prusa3d/MK3_Power_Panic/README.md

# MK3 Power Panic
KiCad PCB layout
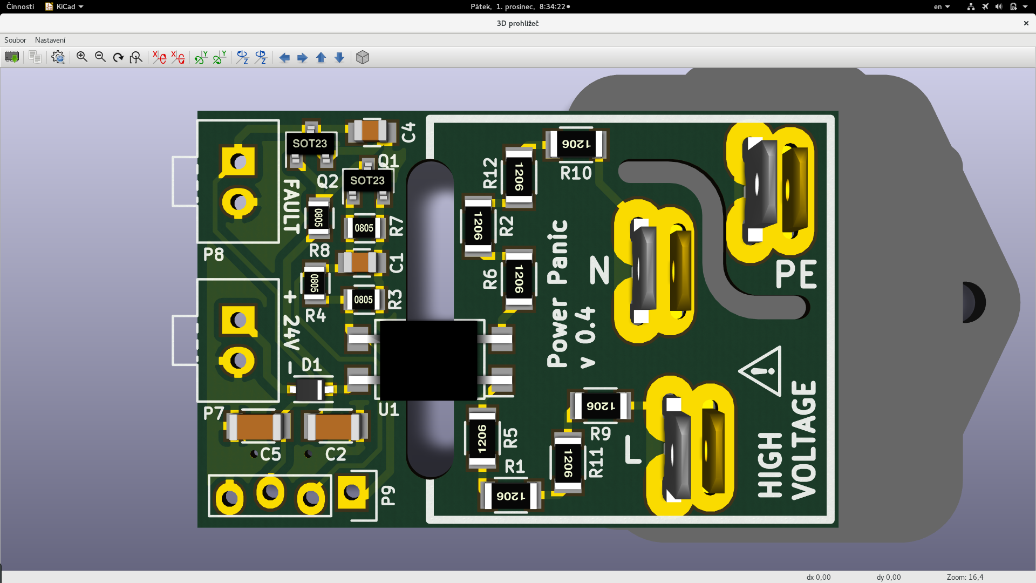
[picture p1: rev.04/power-panic.png]
PCB
