prusa3d/MK3_Power_Panic/rev.04/power-panic.pdf

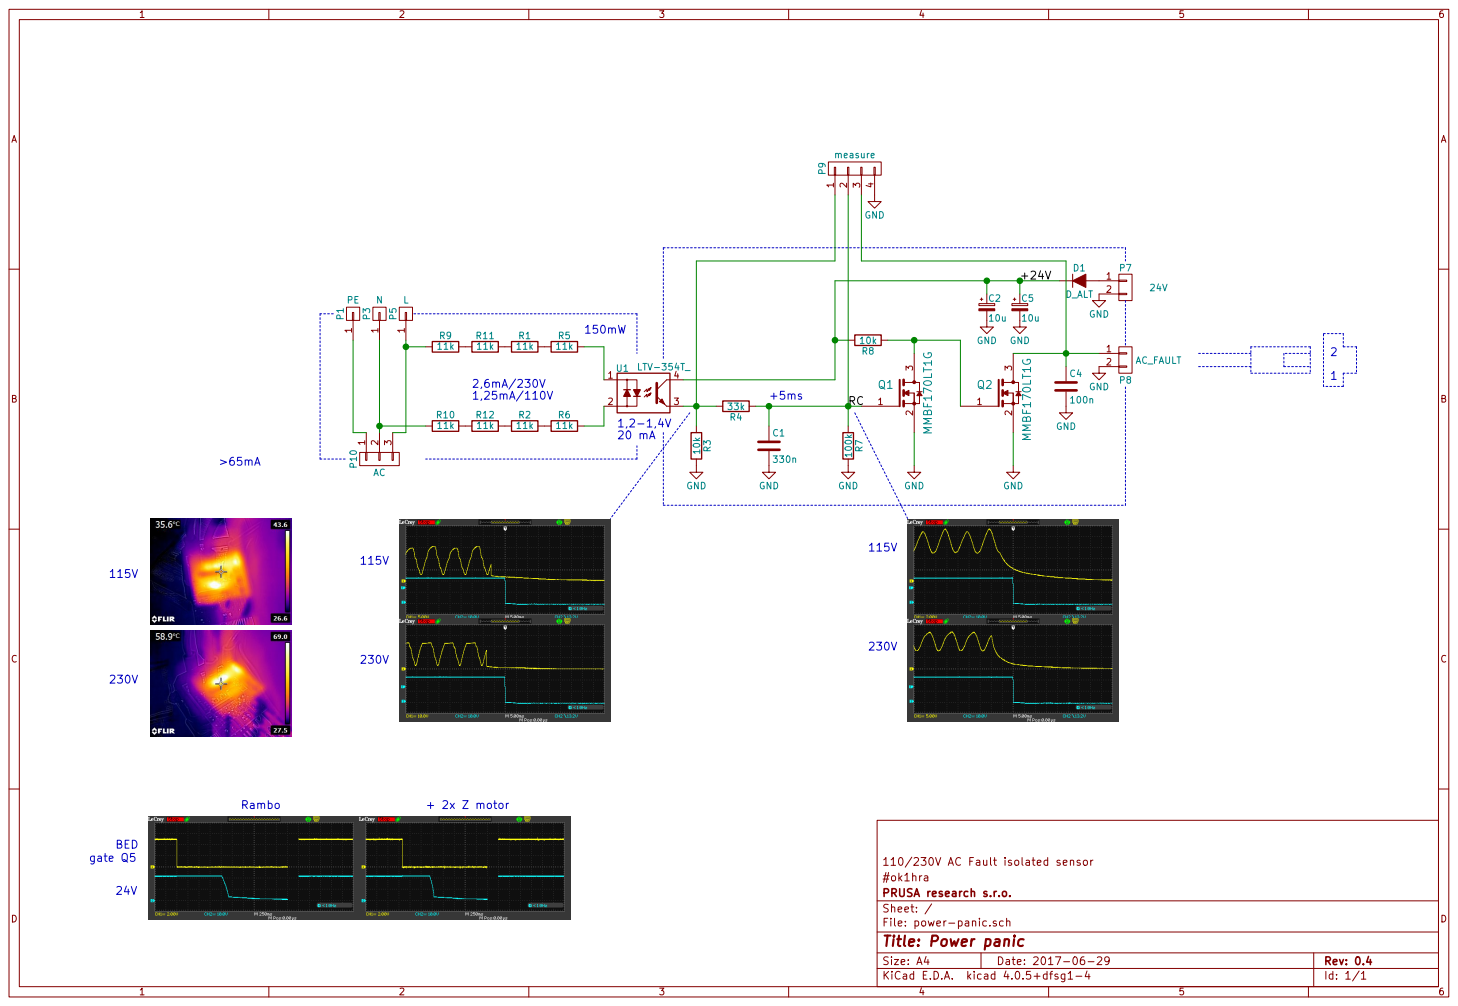
[picture p2: page 1]

https://www.allaboutcircuits.com/tools/capacitor-Charge-and-time-constant-calculator/ 1

110/230V AC Fault isolated sensor
File: power-panic.sch Sheet: / PRUSA research s.r.o. #ok1hra

Id: 1/1 Title: Power panic
