prusa3d/MK3_Power_Panic/rev._Delta_PMZ-24V240WDAL/Delta_PMZ-24V240WDAL.pdf

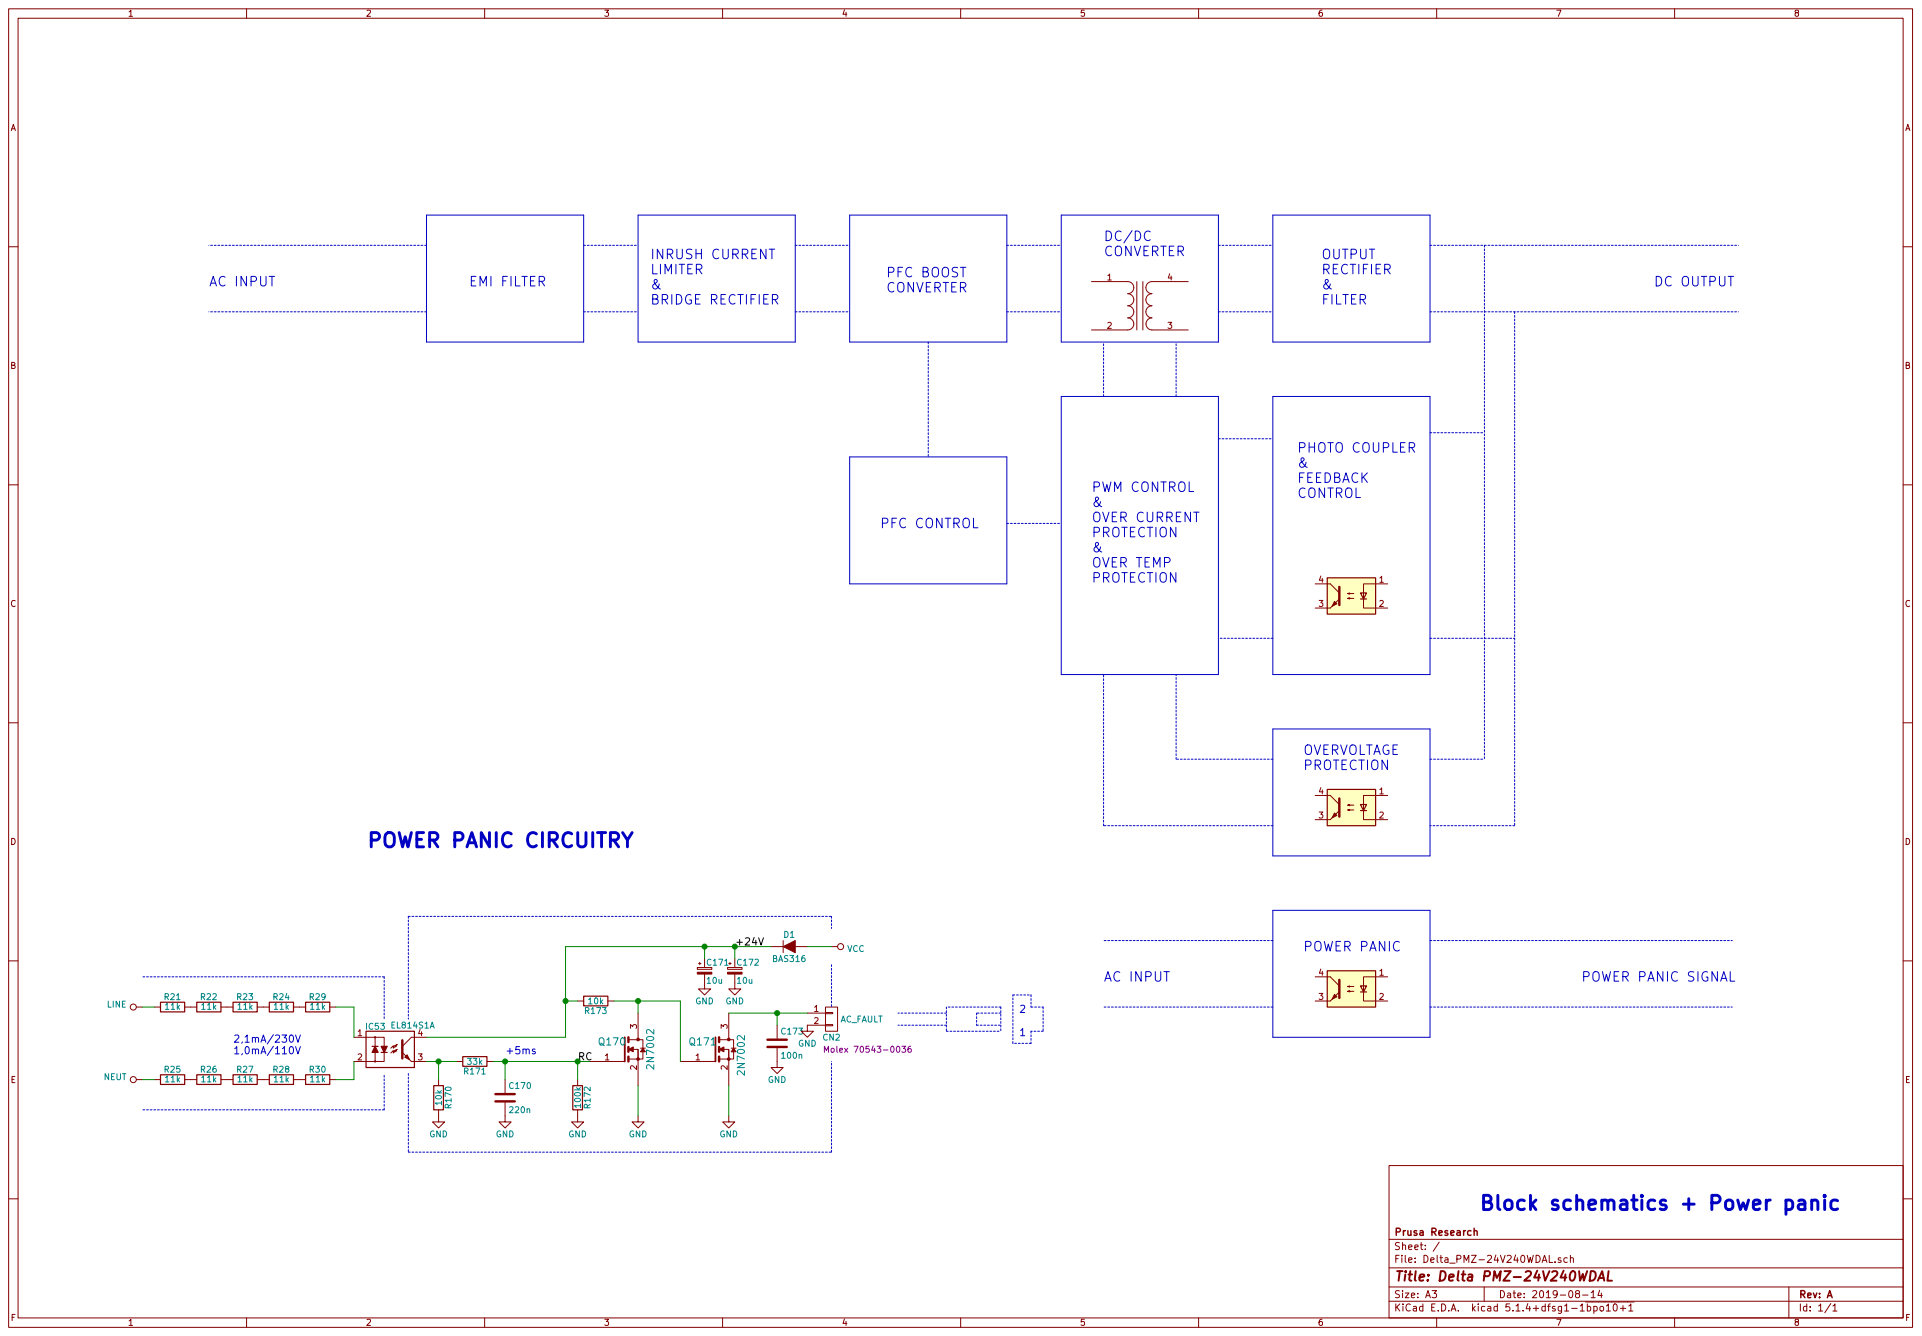
[picture p3: page 1]

File: Delta_PMZ-24V240WDAL.sch Sheet: / Prusa Research C172

Id: 1/1 Title: Delta PMZ-24V240WDAL
