prusa3d/MK3_Power_Panic/rev.04/power-panic.kicad_pcb

## KiCad design rev.04/power-panic.kicad_pcb (2017-12-01)

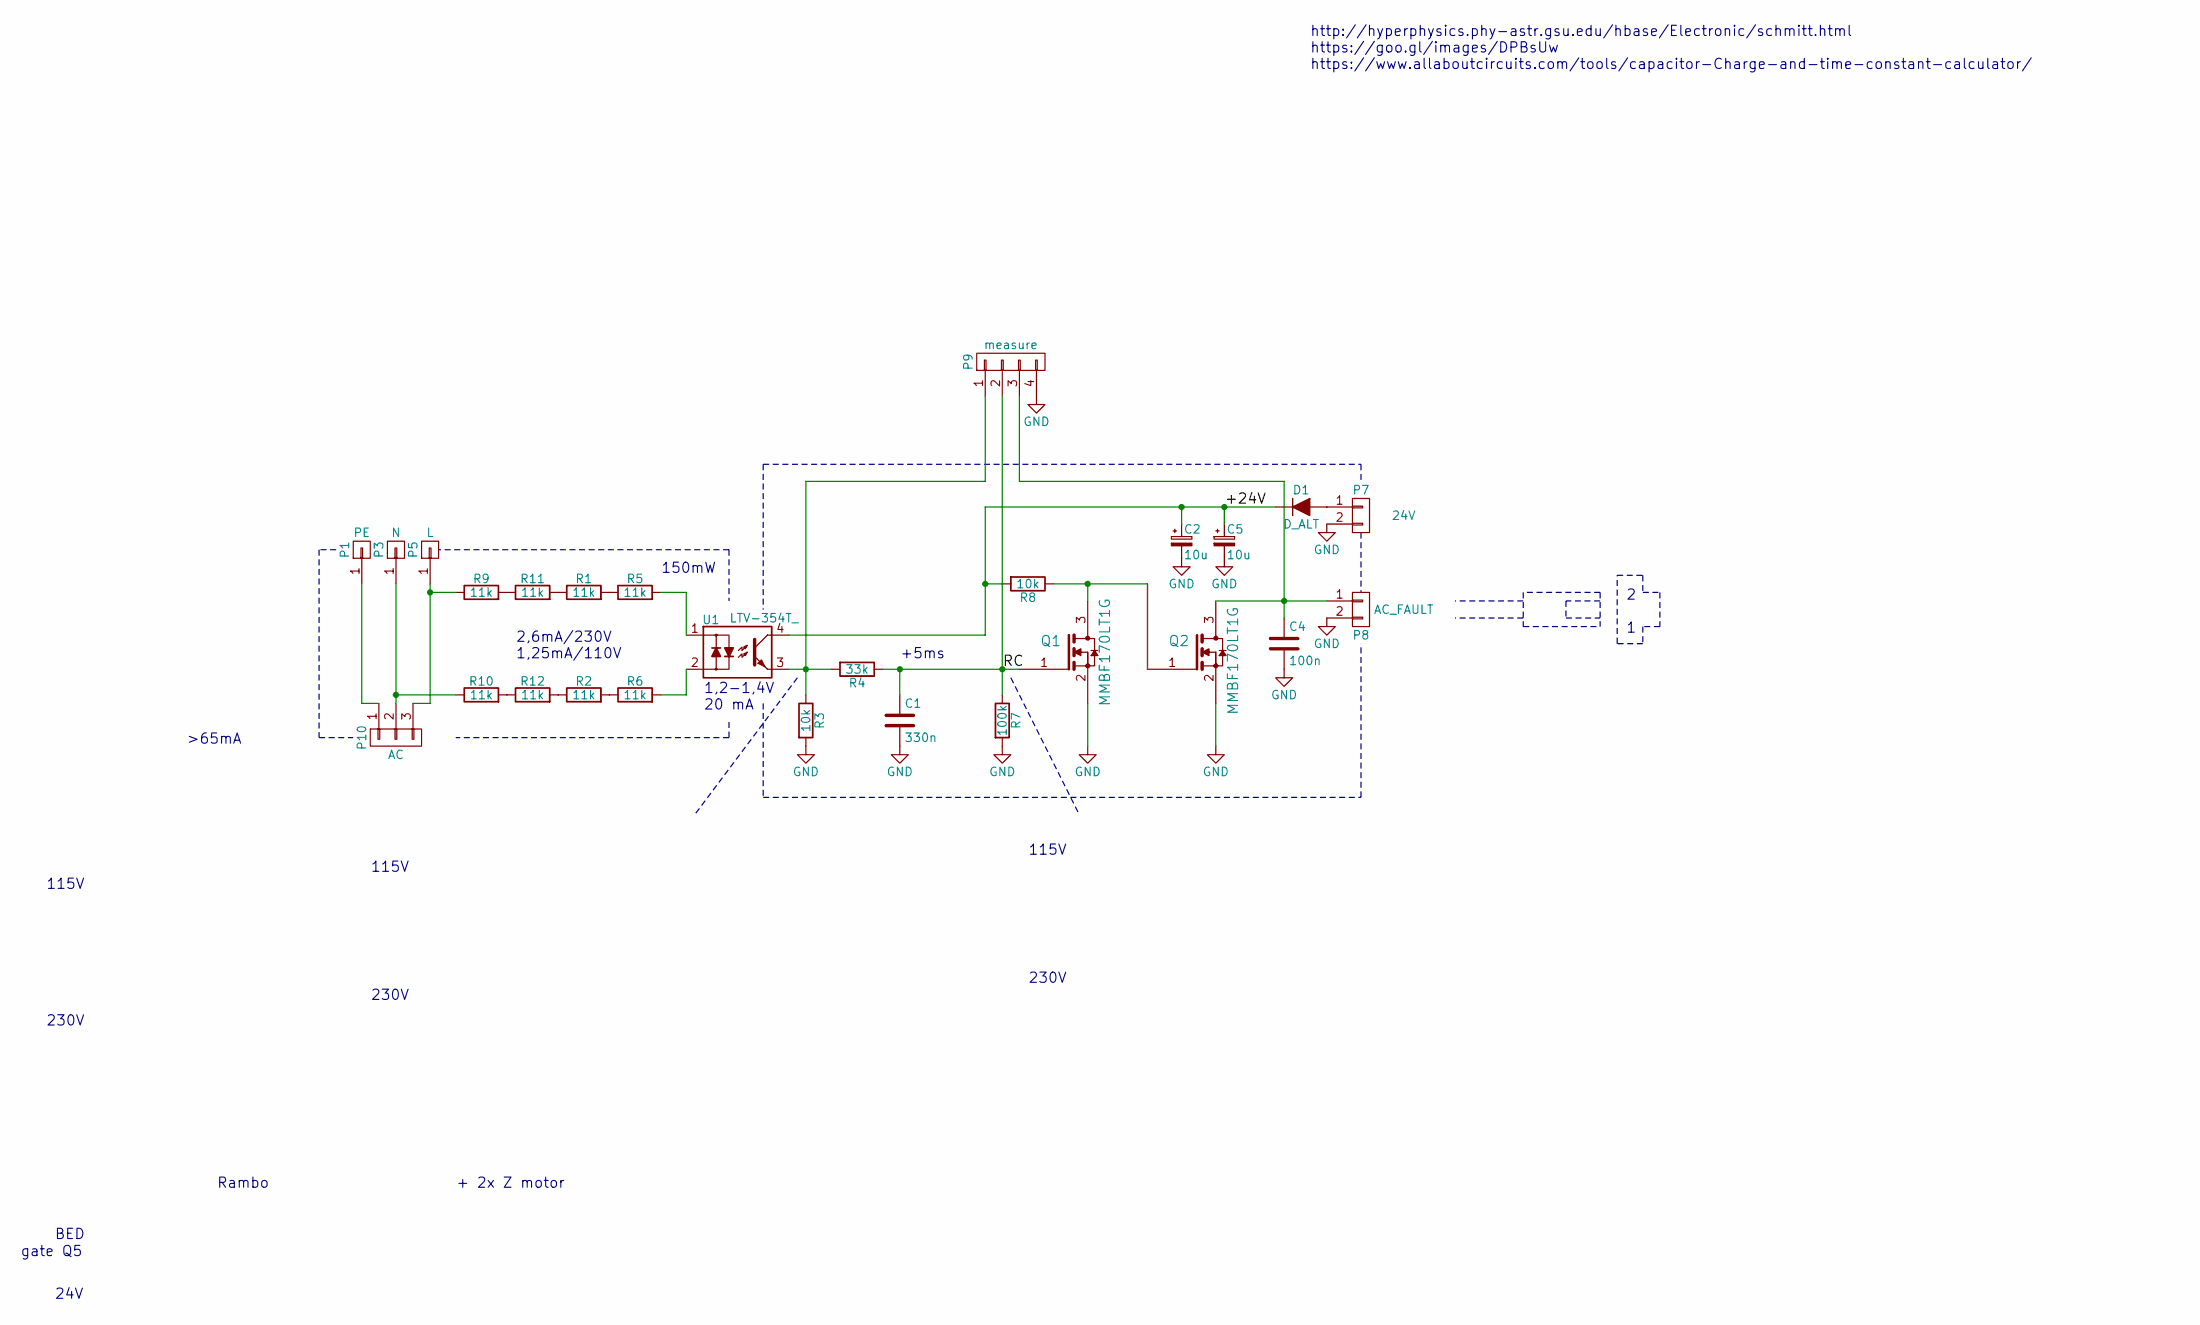
[picture p4: schematic power-panic.sch, Power panic]

Parts:
C1: 330n; C_0805
C2, C5: 10u; C_1206
C4: 100n; C_0805
D1: D_ALT; SOD-323
P1: PE; faston-hole-m
P3: N; faston-hole-m
P5: L; faston-hole-m
P7: 24V; Pin_1x02-XL
P8: AC_FAULT; Pin_1x02-XL
P9: measure; Pin_Header_Straight_1x04
P10: AC; ac-power-plug-fuse
Q1, Q2: MMBF170LT1G; SOT-23
R1, R2, R5, R6, R9, R10, R11, R12: 11k; R_1206
R3, R8: 10k; R_0805
R4: 33k; R_0805
R7: 100k; R_0805
U1: LTV-354T_; Optocoupler_SMD_LTV-817S

Connections:
/+24V: C2.1, C5.1, D1.1 (K), R8.2, U1.4
/RC: C1.1, P9.2, Q1.1, R4.1, R7.1
GND: C1.2, C2.2, C4.2, C5.2, P7.2, P8.2, P9.4, Q1.2, Q2.2, R3.2, R7.2
unnamed: C4.1, P8.1, P9.3, Q2.3
unnamed: D1.2 (A), P7.1
unnamed: P1.1, P10.1
unnamed: P9.1, R3.1, R4.2, U1.3
unnamed: P3.1, P10.2, R10.1
unnamed: P5.1, P10.3, R9.1
unnamed: Q1.3, Q2.1, R8.1
unnamed: R1.1, R11.2
unnamed: R1.2, R5.1
unnamed: R2.2, R6.1
unnamed: R5.2, U1.1
unnamed: R6.2, U1.2
unnamed: R10.2, R12.1
unnamed: R9.2, R11.1
unnamed: R2.1, R12.2

Notes on the sheet:
2,6mA/230V 1,25mA/110V
150mW
http://hyperphysics.phy-astr.gsu.edu/hbase/Electronic/schmitt.html https://goo.gl/images/DPBsUw https://www.allaboutcircuits.com/tools/capacitor-Charge-and-time-constant-calculator/
1,2-1,4V 20 mA
+5ms
115V
230V
>65mA
Rambo
+ 2x Z motor
24V
BED
gate Q5
2 1

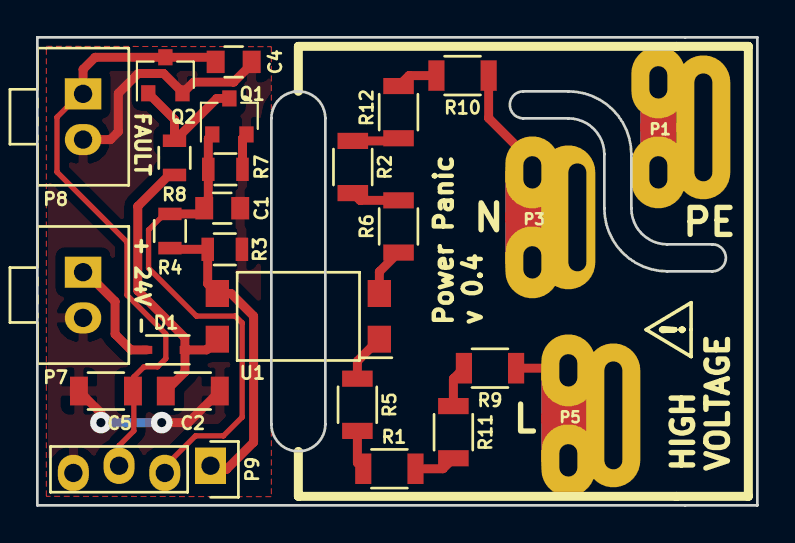
[picture p5: board power-panic.kicad_pcb from above]

Board: 2 copper layers, 40.0 x 26.0 mm, 27 parts (1 on the bottom side), 18 nets.
