prusa3d/MK3_Power_Panic/(threads)

Thread 1 (2017-12-06):

C5 and C2 are not connected on the positive side on the board layout

bwattendorf, 2017-12-06:
When I run the DRC and show unconnected I get an error that C5 and C2 are not connected. I also get an error that pad 3 on P9 and  pad 1 on P8 are not connected but it looks like they are connected when I manually trace the connection.

ok1hra, 2017-12-06:
Yes you're right, C5 are connected versus the original scheme to the output.
It is does not change detector function.
Thanks for feedback.

bwattendorf, 2017-12-06:
Thanks Dan

Bruce W1BAW

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

ok1hra, 2017-12-06:
I see happy ham radio operator also in comerce contact.
CUL on bands Bruce
73, Dan OK1HRA

Zdraví
Dan Pech

Prusa Research s.r.o.
Partyzánská 188/7a
170 00, Praha 7

2017-12-06 21:09 GMT+01:00 bwattendorf <notifications@github.com>:

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

bwattendorf, 2017-12-06:
same here 73

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

bwattendorf, 2017-12-06:
Closing the issue since it is not a problem

make-ing, 2018-03-21:
Hello, i also came across this error (and already opened an issue #5) and it seems very unlikely that this will work the same as described in the schematic. A capacitor (C5) of this size (10µF) will definitely delay the AC_FAULT signal. I hope you will fix either the error in the schematic or in the PCB since i think this will otherwise lead to some more questions and lot of duplicate issue when other people stumble across this inconsistency.

Thanks a lot for the great work so far!

ok1hra, 2018-03-21:
yes, will be fixed in next version

bwattendorf, 2018-03-26:
Dan do you guys need any Beta testers for the new Multi material upgrade?

ok1hra, 2018-03-27:
probably no, sri

bwattendorf, 2018-03-27:
Thanks for the Reply

On Tue, Mar 27, 2018 at 2:47 PM, Dan OK1HRA <notifications@github.com>
wrote:

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

boelle, 2018-08-10:
how can i fix this now? i means it must sure be a simple task?

Closed 2017-12-06.

Thread 2 (2018-01-23):

BOM upload

madhunm, 2018-01-23:
Can you please upload the BOM file; with specific part numbers?

Thanks.

ok1hra, 2018-01-31:
You can generate from KiCad source

madhunm, 2018-02-19:
The KiCad source only has values and packages. Not the exact part number.

ok1hra, 2018-02-19:
But C and R these are the ordinary types, and IOs type exactly specified.

boelle, 2018-08-10:
this is what i have picked from mouser

Reference, Value, Footprint, Datasheet, Mouser
"R1","11k","Resistors_SMD:R_1206_HandSoldering","","667-ERA-8AED113V"
"R4","33k","Resistors_SMD:R_0805_HandSoldering","","660-SG73S2ATTD3302F"
"R5","11k","Resistors_SMD:R_1206_HandSoldering","","667-ERA-8AED113V"
"R2","11k","Resistors_SMD:R_1206_HandSoldering","","667-ERA-8AED113V"
"R6","11k","Resistors_SMD:R_1206_HandSoldering","","667-ERA-8AED113V"
"P8","AC_FAULT","Connectors_Molex:Molex_KK-6410-02_02x2.54mm_Straight",""
"U1","LTV-354T_","Opto-Devices:Optocoupler_SMD_LTV-817S",""
"R3","10k","Resistors_SMD:R_0805_HandSoldering","","660-RK73H2ATTDD1002F"
"Q2","MMBF170LT1G","TO_SOT_Packages_SMD:SOT-23",""
"R7","100k","Resistors_SMD:R_0805_HandSoldering","","660-RK73H2ATTE1003F"
"Q1","MMBF170LT1G","TO_SOT_Packages_SMD:SOT-23",""
"R8","10k","Resistors_SMD:R_0805_HandSoldering","","660-RK73H2ATTDD1002F"
"D1","D_ALT","Diodes_SMD:D_SOD-323_HandSoldering","","863-BAS16HT1G"
"C4","100n","Capacitors_SMD:C_0805_HandSoldering","","710-885012207098"
"C1","0.33uF","Capacitors_SMD:C_0805_HandSoldering","","77-VJ0805V334ZXACBC"
"P7","24V","Connectors_Molex:Molex_KK-6410-02_02x2.54mm_Straight",""
"C5","10u","Capacitors_Tantalum_SMD:CP_Tantalum_Case-A_EIA-3216-18_Hand","","581-TCJA106M025R0150"
"C2","10u","Capacitors_Tantalum_SMD:CP_Tantalum_Case-A_EIA-3216-18_Hand","","581-TCJA106M025R0150"
"R9","11k","Resistors_SMD:R_1206_HandSoldering","","667-ERA-8AED113V"
"R11","11k","Resistors_SMD:R_1206_HandSoldering","","667-ERA-8AED113V"
"R10","11k","Resistors_SMD:R_1206_HandSoldering","","667-ERA-8AED113V"
"R12","11k","Resistors_SMD:R_1206_HandSoldering","","667-ERA-8AED113V"
"P9","measure","Connectors_Molex:Molex_KK-6410-04_04x2.54mm_Straight",""

i have not  added the optocoupler yet and not the connectors... i will edit this post when i have found everything.... part number from mouser is last on each line.... C2 and C5 are not correct yet

Closed 2018-01-31.

Thread 3 (2018-03-19):

D1 hast no description/specification

libxmike, 2018-03-19:
please include D1 Zener Diode specification

ok1hra, 2018-03-19:
D1 not a Zener diode.
Suit any standard type.

libxmike, 2018-03-19:
the one on my power panic is A6 L which is Zener BAS316 SOD323 package

boelle, 2018-08-10:
i picked BAS16HT1G from on semiconductor

https://www.mouser.dk/ProductDetail/ON-Semiconductor/BAS16HT1G?qs=vLkC5FC1VN%2flO2e9rESqmg==

Closed 2018-03-19.

Thread 4 (2018-03-20):

C2 and C5 capacitor, ceramic or tantalum?

libxmike, 2018-03-20:
on the diagram there is "+" which means it is tantalum (or elko capacitor) but on the PCB there is an ceramic capacitor, what is correct? ceramic or tantalum?

make-ing, 2018-03-21:
I would guess that its a normal ceramic capacitor, as there are only very few 10µF (+25V 1206) tantalum caps on Digikey available. It also doesn't seem to be necessary from a capacity or ESR standpoint to put tantalum caps here. But i'm a little bit confused since there seems to be an error in the PCB reagarding to connection of C5. I opened a separate issue about this #5.

libxmike, 2018-03-21:
yes, it is 1206 ceramic.

ok1hra, 2018-03-21:
yes, all is ceramic

amoose136, 2018-05-29:
Well I'm about to build one with some tantalum caps so I guess it will blow up if it really matters.

Thread 5 (2018-03-21):

PCB C5 wrong trace connection?

make-ing, 2018-03-21:
When i open the PCB its seems that there is an error in the connection of C5. It is connected to Net-(C4-Pad1) instead of the +24V net. The DRC confirms this error. Either the schematic or the PCB layout has an error. Can you please check this?

Thanks a lot for the awesome work!

make-ing, 2018-03-21:
i overlooked an already closed issue about this here #1.

Closed 2018-05-03.

Thread 7 (2018-05-13):

Replace 11k resistor with cap

luxarts, 2018-05-13:
Hello!

I was suprised when I saw the 8 resistors at the AC input. Why not a capacitor? I don't think the phase shift between voltage and current matters.
The total resistance it's 88k. In my country the frequency of the AC it's 50Hz. Doing the math:

Xc = 1/(2 * π * freq * c) -> c= 1/(2 * π * freq * Xc)

To get 88k: 1/(2 * π * 50 * 88k) = 36.17nF aprox.
The close comercial value it's 39nF, getting 81.6k aprox.

Less power disipation, less heat, less footprint.

Regards,
Lucas

ok1hra, 2018-05-13:
Yes, but high voltage capacitor more expensive than resistors.

boelle, 2018-08-10:
i agree with @ok1hra, the power consumption is 150 mW and replacing the resistors with a capacitor to save a little just dont justify the more expensive capacitor

Closed 2018-08-23.

Thread 8 (2018-05-17):

Fix P8 pinout

tjhawkey, 2018-05-17:
It's not 1:1 with the einsy.
Doesn't matter that much since the wires are soldered in, but it's still bad practice.

boelle, 2018-08-10:
what should it be in the end? i have the board open and have changed it to 2 pin molex kk connectors

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

i have only changed one of them as i need to move them and then move tracks and make sure everything will still pass check at board houses

Thread 9 (2018-05-31):

wrl/x3d file for optoisolator footprint

amoose136, 2018-05-31:
A number of footprint files reference \home\dan\kicad\hra\lib\ok1hra and I think this includes the optoisolator. I could remodel it myself but is it available anywhere?

ok1hra, 2018-05-31:
Every footprint may be export from pcb via Properties/Footprint Editor/ Export footprint

boelle, 2018-08-10:
just use one of the 3dshapes that comes with kicad, worked for me

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

but i agree that everything needed to open the files without any error should be included

Thread 10 (2018-06-20):

nozzle temp not set issue

silserwis, 2018-06-20:
I have MK3 firmware 3.2.1-576
After power panic nozzle temp is not set correctly. I must manually set it.
heatbed temp is set OK.

boelle, 2018-08-10:
that has nothinf to do with the power panic board

the only thing the board do is telling the einsy board that power is lost

Thread 11 (2018-08-10):

Ac power plug

boelle, 2018-08-10:
what make/brand and part number is the ac plug

i have looked arround and not found one that will match the board

boelle, 2018-08-10:
yeah, it would be my next step,

please note that there is a connection issue between C2 and C5

boelle, 2018-08-10:
oh yes... i dont care much about what socket is used... as long i know which one

boelle, 2018-08-10:
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

look at the 2 white lines.... it has been discussed on one of the other issues (might be one of the closed ones) all we got to know is that it will be fixed in next version but not how we could fix it our selfes

boelle, 2018-08-12:
@amoose136 like this?

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

amoose136, 2018-08-12:
That's almost what I'm going to do except the board will stick out in the opposite direction because of the a particulars of how my power supply is mounted relative to the switch.

amoose136, 2018-08-12:
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
Remap like so, rerun DRC -> refill zones. Warnings go away and connectivity matches the schematic. Thing is this is electrically different from the board as given. In the schematic C5 is on a separate net from P9 pin 3. On the schematic it seems that P9 exists to create probe points for diagnostic reasons but the printer doesn't care about all that. I think if you don't care if ground is on the edge pin of p9, you could swap pin 4 with pin 3 on the schematic and then all of the ground plane can be contiguous on the front so the back would be redundant and the two vias can be eliminated.

amoose136, 2018-08-12:
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
Examples of this change are attached.

boelle, 2018-08-12:
Thanks, would be nice if  @ok1hra  can confirm this is how he would fix it for the next version

Deneteus, 2018-10-08:
The closest I found to original is this Cat. No 57411. Except the Prusa Mk.3 one doesn't have the locking tabs.
http://www.internationalconfig.com/documents/57411.pdf

Closed 2019-03-19.

Thread 12 (2019-03-04):

Update the design files to reflect the Power Panic integration into the DELTA PSU

CacikeOtoao, 2019-03-04:
@ok1hra , Please update this repo to include the new design of the integrated Power Panic board into the PSU. Even if it is a customized PSU, the design files should be updated since the design changes would need to comply with the Open Source nature of the repo.

maximlevitsky, 2019-03-20:
I second that.

CacikeOtoao, 2019-04-29:
@ok1hra, @josefprusa, can we get an official word on this please?

maximlevitsky, 2019-07-16:
Any update???!!!

CacikeOtoao, 2019-07-16:
No design files will be made available. I was told that Prusa Research instructed Delta not to disclose the files nor make the PSU available to third parties.

CacikeOtoao, 2019-07-27:
Since there has been no comment or statement made in regards to this issue I will be flagging this on Github as a GPL violation. This project was obviously modified to be fitted inside a Delta PSU and you did not update the project to reflect that.

maximlevitsky, 2019-07-29:
To be really honest, despite the fact that it is sad to see the powerpanic go (it actually called [UVLO](https://en.wikipedia.org/wiki/Undervoltage-lockout) in technical terms, which I found kind of cool),
the power panic circuit is just a bunch of resistors to reduce the incoming voltage, then a optoisolator for safety, and then two transistors that do the very basic job of rectification of the current.

In a PSU, the same functionality can probably be done by connecting to some internal line.
Basically a line with low enough voltage but before the big capacitor, so that line looses voltage immediately and without delay.

So I am inclined to think that there is nothing from the actual GPL code that was used.

Deneteus, 2019-08-12:
Nothing in this design is a secret. Even if he made it so Delta couldn't release the design files it takes maybe 10 minutes (with experience) to open one up and figure it out yourself if you already have one of the new PSU's. I still would want the design out there just in case there is an issue with their PSU that nobody knows about. There have been too many safety issues with PSU's failing due to bad designs to not want to know how it was integrated.
https://www.edn.com/design/test-and-measurement/4361392/Circuit-monitors-ac-power-loss

ok1hra, 2019-08-19:
Now available here https://github.com/prusa3d/MK3_Power_Panic/blob/master/rev._Delta_PMZ-24V240WDAL/Delta_PMZ-24V240WDAL.pdf

maximlevitsky, 2019-08-21:
I am proud of the decision to release this.
Even though this is mostly a formal thing since as I explained above, there is not much to hide there anyway, but still.

Happy printing!

Closed 2019-08-19.

Thread 13 (2020-03-25):

ok1hra library not found

elektronchika, 2020-03-25:
Hi there,

When I open the schematic I get an error that ok1hra library is not found. Then the components from this library don't have bodies in 3D view. Where from can I download this library?

Thank you!
